ArkhamKnightGPC/PCS3858-EmbeddedSystemsLab/imagens/Interface_NoFingerDetected.PNG

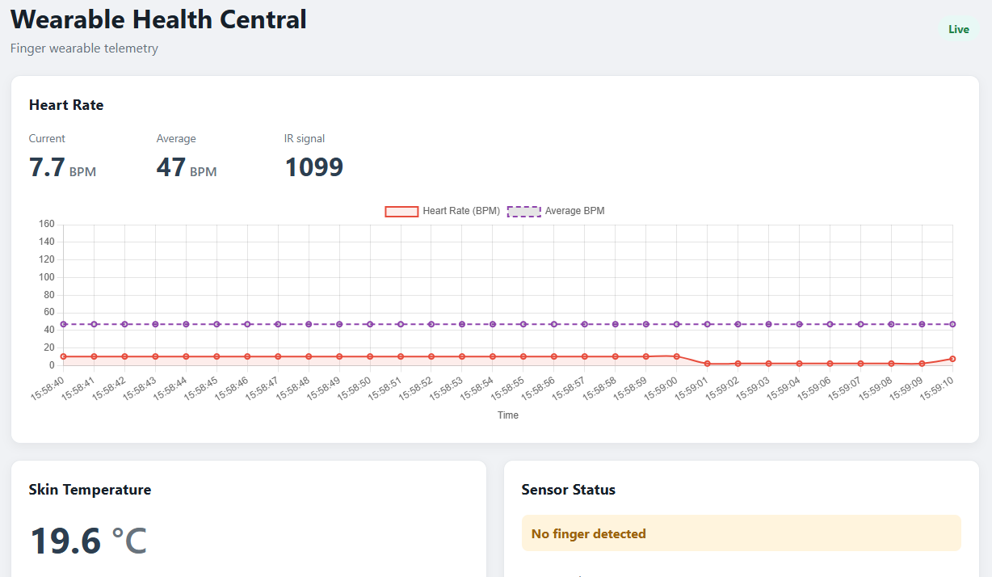
imagens/Interface_NoFingerDetected.PNG
