ArkhamKnightGPC/PCS3858-EmbeddedSystemsLab/imagens/Prototype_ESP32_Rpi.png

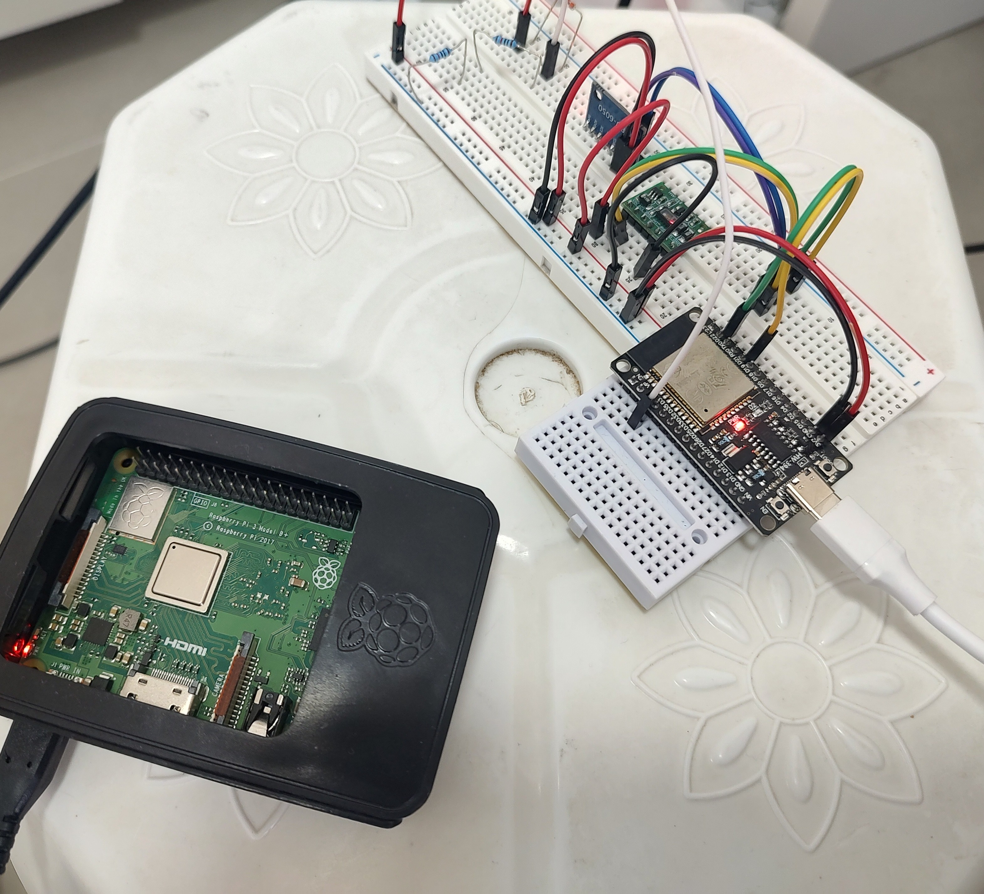
imagens/Prototype_ESP32_Rpi.png
