ArkhamKnightGPC/PCS3858-EmbeddedSystemsLab/imagens/Prototype_ESP32breadboard.png

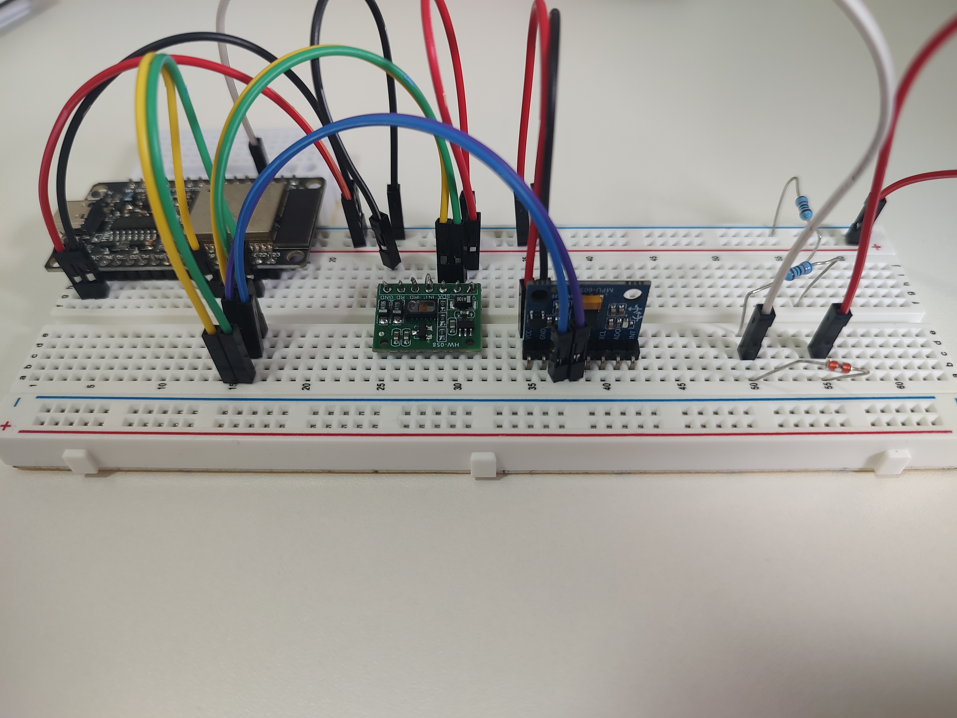
imagens/Prototype_ESP32breadboard.png
