ArkhamKnightGPC/PCS3858-EmbeddedSystemsLab/imagens/I2C_operationPrinciple.png

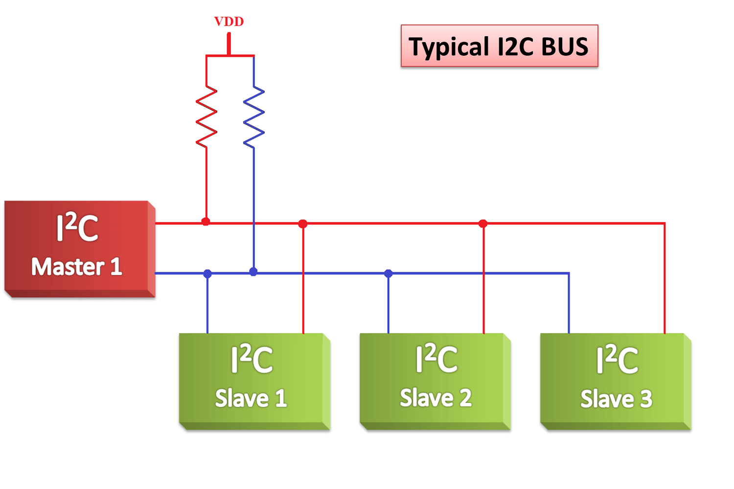
imagens/I2C_operationPrinciple.png
