ArkhamKnightGPC/PCS3858-EmbeddedSystemsLab/imagens/MAX30102_operationPrinciple.png

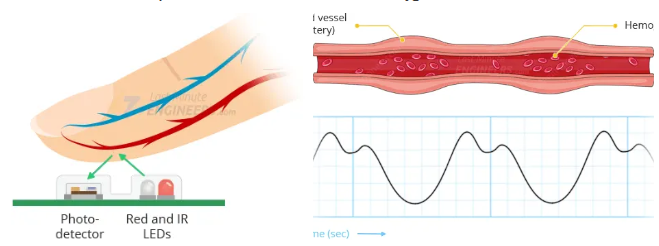
imagens/MAX30102_operationPrinciple.png
