ArkhamKnightGPC/PCS3858-EmbeddedSystemsLab/wearable_finger/wearable_finger.ino

#include <Arduino.h>
#include <WiFi.h>
#include <PubSubClient.h>
#include <Wire.h>
#include "MAX30105.h"
#include "heartRate.h"
#include "secrets.h"

// --- Network and MQTT Configuration ---
const char *MQTT_BROKER = "10.144.4.16";
const uint16_t MQTT_PORT = 1883;
const char *MQTT_TOPIC = "wearable/finger/measurements";

WiFiClient wifiClient;
PubSubClient mqttClient(wifiClient);

unsigned long lastWifiConnectionAttempt = 0;
unsigned long lastMqttConnectionAttempt = 0;
const unsigned long WIFI_RECONNECT_INTERVAL = 10000;
const unsigned long MQTT_RECONNECT_INTERVAL = 5000;

// --- Hardware Pin Definitions ---
const int adcPin = 34; // NTC 20k thermistor connected to GPIO 34 (ADC1_6)

// --- NTC 20k Parameters ---
const float R_REF = 47000.0;        // Fixed 47k resistor value (ohms)
const float NOMINAL_R = 20000.0;    // Resistance at 25°C (20k ohms)
const float NOMINAL_T = 25.0;       // Nominal temperature in °C
const float B_COEFFICIENT = 3950.0; // Beta value

// --- MAX30102 Parameters ---
MAX30105 particleSensor;
const byte RATE_SIZE = 4;
byte rates[RATE_SIZE];
byte rateSpot = 0;
long lastBeat = 0;
float beatsPerMinute = 0;
int beatAvg = 0;

// --- Timing Control Variables ---
unsigned long lastTempReadTime = 0;
const unsigned long TEMP_INTERVAL = 1000; // Read temperature every 1000ms (1 second)

// Variable to store latest temperature reading
float currentTempC = 0.0;
bool validTempRead = false;

void connectToWifi() {
  if (WiFi.status() == WL_CONNECTED) {
    return;
  }

  unsigned long now = millis();
  if (lastWifiConnectionAttempt != 0 &&
      now - lastWifiConnectionAttempt < WIFI_RECONNECT_INTERVAL) {
    return;
  }

  lastWifiConnectionAttempt = now;
  Serial.printf("Connecting to Wi-Fi network %s...\n", WIFI_SSID);
  WiFi.disconnect();
  WiFi.begin(WIFI_SSID, WIFI_PASSWORD);
}

void connectToMqtt() {
  if (WiFi.status() != WL_CONNECTED || mqttClient.connected()) {
    return;
  }

  unsigned long now = millis();
  if (lastMqttConnectionAttempt != 0 &&
      now - lastMqttConnectionAttempt < MQTT_RECONNECT_INTERVAL) {
    return;
  }

  lastMqttConnectionAttempt = now;

  // The MAC suffix makes the client ID unique if more wearables are added.
  uint64_t chipId = ESP.getEfuseMac();
  char clientId[32];
  snprintf(clientId, sizeof(clientId), "wearable-finger-%04X",
           static_cast<unsigned int>(chipId & 0xFFFFULL));

  Serial.printf("Connecting to MQTT broker %s:%u...\n", MQTT_BROKER,
                MQTT_PORT);
  if (mqttClient.connect(clientId, MQTT_USERNAME, MQTT_PASSWORD)) {
    Serial.println("Connected to MQTT broker.");
  } else {
    Serial.printf("MQTT connection failed (state %d).\n", mqttClient.state());
  }
}

void maintainNetworkConnections() {
  if (WiFi.status() != WL_CONNECTED) {
    connectToWifi();
    return;
  }

  connectToMqtt();
  if (mqttClient.connected()) {
    mqttClient.loop();
  }
}

void publishMeasurements(long irValue) {
  if (!mqttClient.connected()) {
    Serial.println("Measurement not published: MQTT is disconnected.");
    return;
  }

  char payload[256];
  const bool fingerDetected = irValue >= 50000;

  if (validTempRead) {
    snprintf(payload, sizeof(payload),
             "{\"ir\":%ld,\"bpm\":%.1f,\"avg_bpm\":%d,"
             "\"finger_detected\":%s,\"temperature_c\":%.1f,"
             "\"temperature_valid\":true}",
             irValue, beatsPerMinute, beatAvg,
             fingerDetected ? "true" : "false", currentTempC);
  } else {
    snprintf(payload, sizeof(payload),
             "{\"ir\":%ld,\"bpm\":%.1f,\"avg_bpm\":%d,"
             "\"finger_detected\":%s,\"temperature_c\":null,"
             "\"temperature_valid\":false}",
             irValue, beatsPerMinute, beatAvg,
             fingerDetected ? "true" : "false");
  }

  if (!mqttClient.publish(MQTT_TOPIC, payload)) {
    Serial.println("Failed to publish MQTT measurement.");
  }
}

void setup() {
  Serial.begin(115200);
  delay(1000);
  Serial.println("Initializing System...");

  WiFi.mode(WIFI_STA);
  mqttClient.setServer(MQTT_BROKER, MQTT_PORT);
  mqttClient.setBufferSize(256);
  connectToWifi();

  // Initialize ADC Resolution for ESP32
  analogReadResolution(12);

  // Initialize I2C bus on ESP32-WROOM-DA default pins (SDA=21, SCL=22)
  Wire.begin(21, 22);

  // Initialize MAX30102 Sensor
  if (!particleSensor.begin(Wire, I2C_SPEED_FAST)) {
    Serial.println("MAX30102 was not found. Please check wiring/power.");
    while (1);
  }

  Serial.println("MAX30102 found! Place your finger on the sensor with steady pressure.");

  particleSensor.setup();
  particleSensor.setPulseAmplitudeRed(0x0A); // Turn Red LED low for indication
  particleSensor.setPulseAmplitudeGreen(0);  // Turn off Green LED
}

void loop() {
  maintainNetworkConnections();

  // -------------------------------------------------------------
  // 1. MAX30102 Heart Rate Processing (Runs continuously)
  // -------------------------------------------------------------
  long irValue = particleSensor.getIR();

  if (checkForBeat(irValue) == true) {
    long delta = millis() - lastBeat;
    lastBeat = millis();

    beatsPerMinute = 60.0 / (delta / 1000.0);

    if (beatsPerMinute < 255 && beatsPerMinute > 20) {
      rates[rateSpot++] = (byte)beatsPerMinute;
      rateSpot %= RATE_SIZE;

      beatAvg = 0;
      for (byte x = 0; x < RATE_SIZE; x++) {
        beatAvg += rates[x];
      }
      beatAvg /= RATE_SIZE;
    }
  }

  // -------------------------------------------------------------
  // 2. NTC 20k Temperature Reading (Runs every 1 second non-blocking)
  // -------------------------------------------------------------
  if (millis() - lastTempReadTime >= TEMP_INTERVAL) {
    lastTempReadTime = millis();

    int rawValue = analogRead(adcPin);
    float voltage = (rawValue / 4095.0) * 3.3;

    if (voltage > 0.05 && voltage < 3.25) {
      float rNtc = R_REF * ((3.3 / voltage) - 1.0);
      float tempKelvin = 1.0 / ((1.0 / (NOMINAL_T + 273.15)) + (log(rNtc / NOMINAL_R) / B_COEFFICIENT));
      currentTempC = tempKelvin - 273.15;
      validTempRead = true;
    } else {
      validTempRead = false;
    }

    // -------------------------------------------------------------
    // 3. Publish Combined Data to MQTT
    // -------------------------------------------------------------
    publishMeasurements(irValue);
  }
}
