ArkhamKnightGPC/PCS3858-EmbeddedSystemsLab/wearable_esp32/secrets.example.h

#pragma once

// Copy to secrets.h (ignored by Git) and configure locally before uploading.
const char *WIFI_SSID = "YOUR_WIFI_SSID";
const char *WIFI_PASSWORD = "YOUR_WIFI_PASSWORD";
const char *MQTT_USERNAME = "YOUR_MQTT_USERNAME";
const char *MQTT_PASSWORD = "YOUR_MQTT_PASSWORD";
#define WEARABLE_MQTT_BROKER "10.197.100.243"
