ArkhamKnightGPC/PCS3858-EmbeddedSystemsLab/(commit log)

2026-09-25 add ESP32-C3 mini datasheet link and pin layout image
2026-09-26 obtain valid measurements from thermistor and MAX30102 sensors on ESP32 setup
2026-10-08 app version 0: finger wearable data collection, server Flask app, update READMEs
2026-10-09 add I2C scanner script
2026-10-11 Fix typo in Raspberry Pi link in README.md
2026-10-23 add roll and pitch visualization to MPU6050
2026-10-23 refine roll and pitch card on dashboard
2026-10-23 add temperature time series chart and numeric values to roll-pitch visualisation
2026-10-23 computational cost of webapp was too high for Rpi... implementation of simplified roll-pitch visualizer
2026-10-23 test dip in acceleration to detect free fall, implement batching to increase frequency of ESP32 measurement collection
2026-10-23 ESP32 handles fall detection, Rpi awaits special cancellation via LED button, when pressed special message is sent for cancellation in case of false positive
2026-10-23 enforce MQTT JSON compatibility between Rpi and ESP32, refine fall detection mechanism
2026-11-06 fix: restore MQTT telemetry and dashboard navigation
    [secrets.example.h]
2026-11-06 fix: restore wearable I2C telemetry contract
    [wearable_esp32.ino]
2026-11-06 fix: support MPU-compatible wearable sensor
    [wearable_esp32.ino]
